JordanAceto/DIY_Synth_Workshop_2020/workshop_docs/pictoral_walkthrough.odp

## Step 1

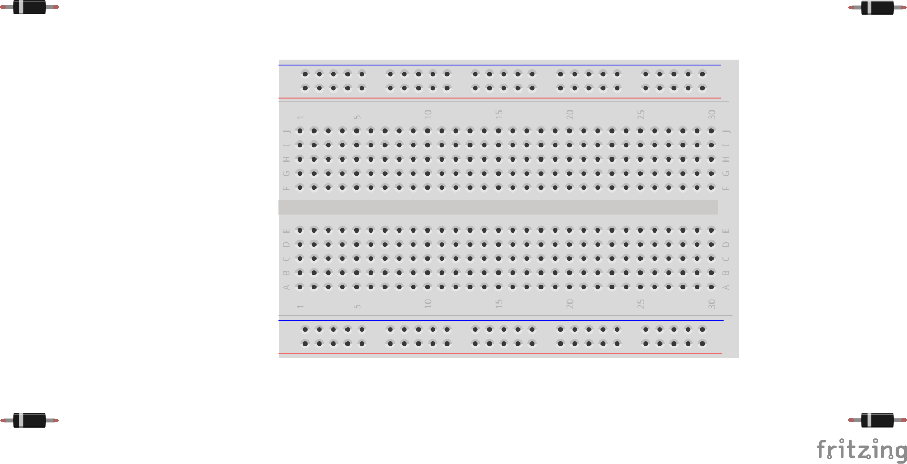
[picture p3: figure]

## Step 2

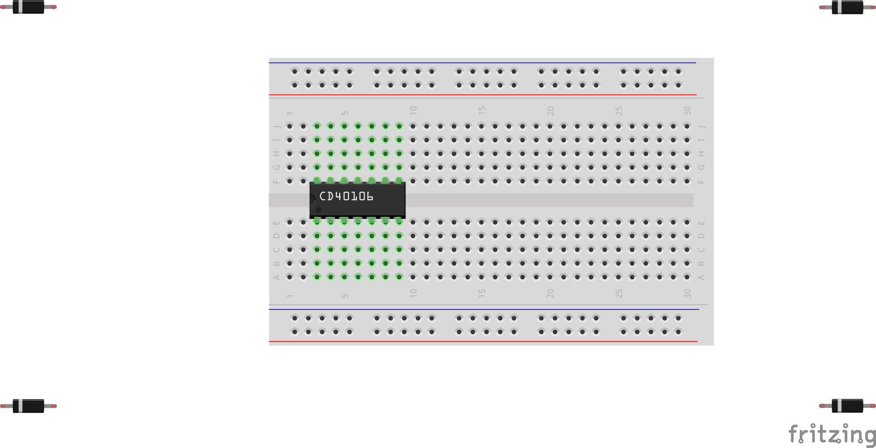
[picture p4: figure]

## Step 3

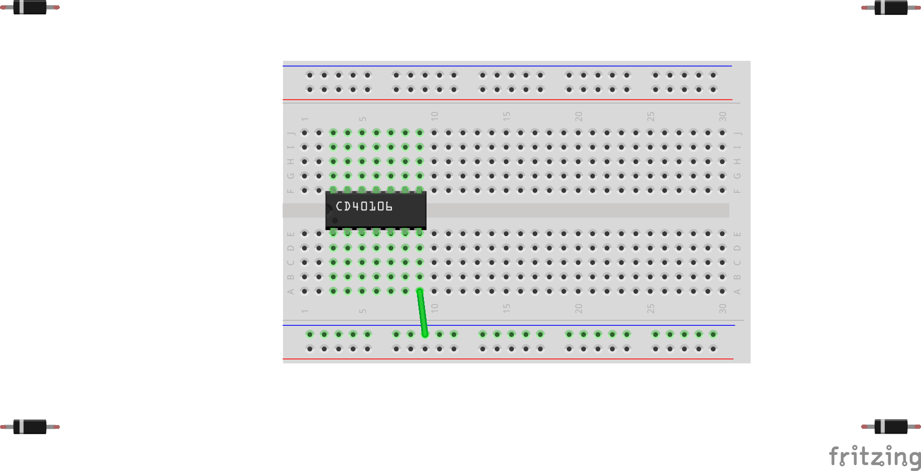
[picture p5: figure]

## Step 4

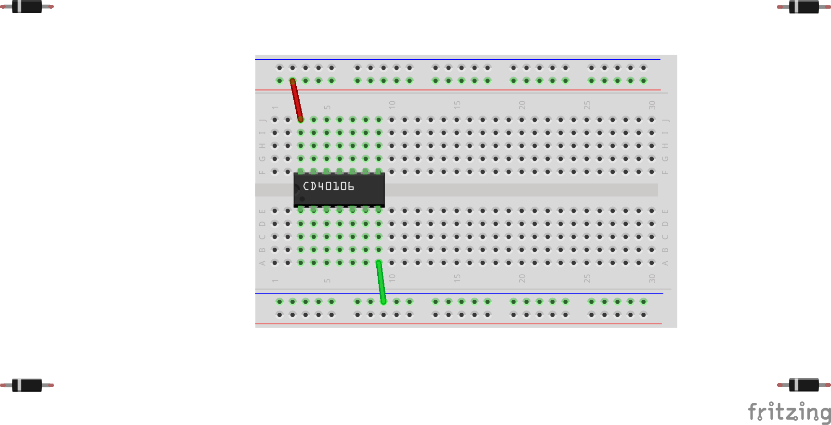
[picture p6: figure]

## Step 5

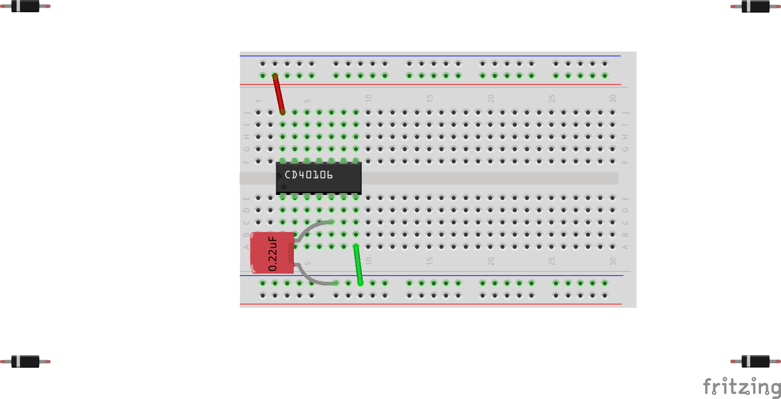
[picture p7: figure]

## Step 6

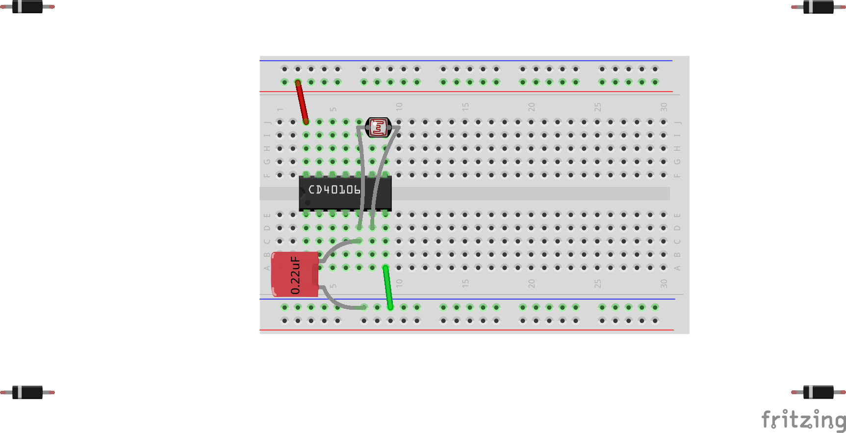
[picture p8: figure]

## Step 7

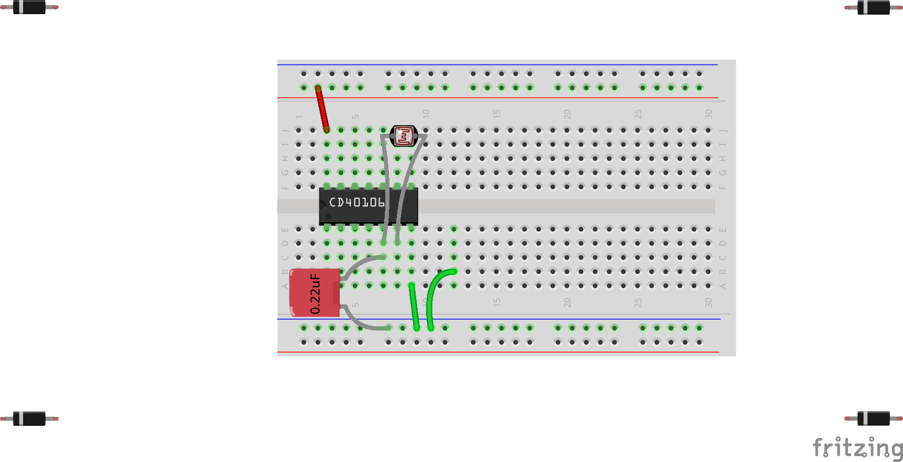
[picture p9: figure]

## Step 8

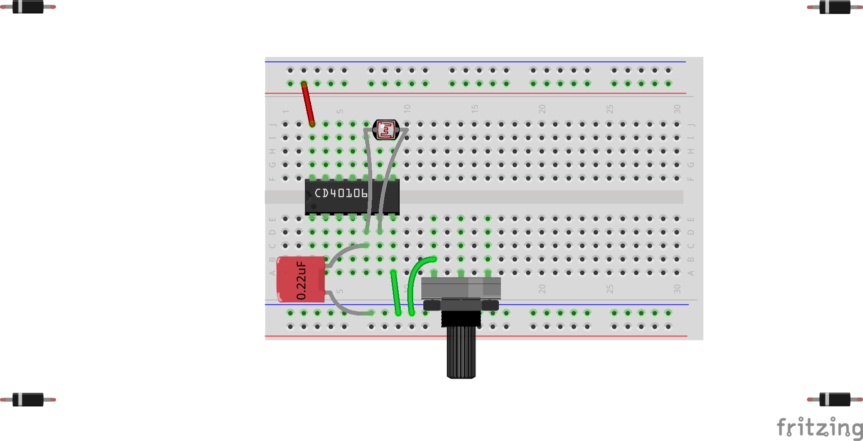
[picture p10: figure]

## Step 9

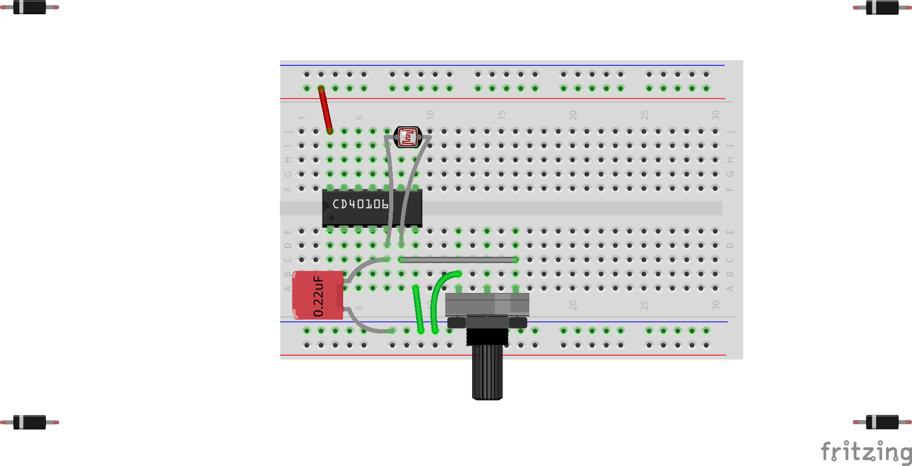
[picture p11: figure]

## Step 10

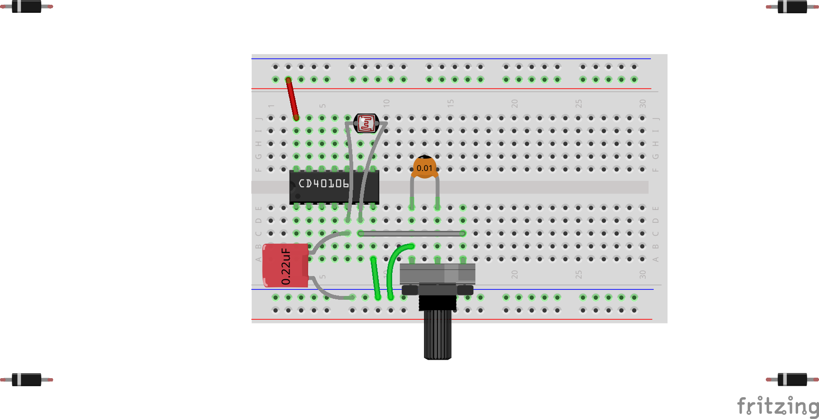
[picture p12: figure]

## Step 11

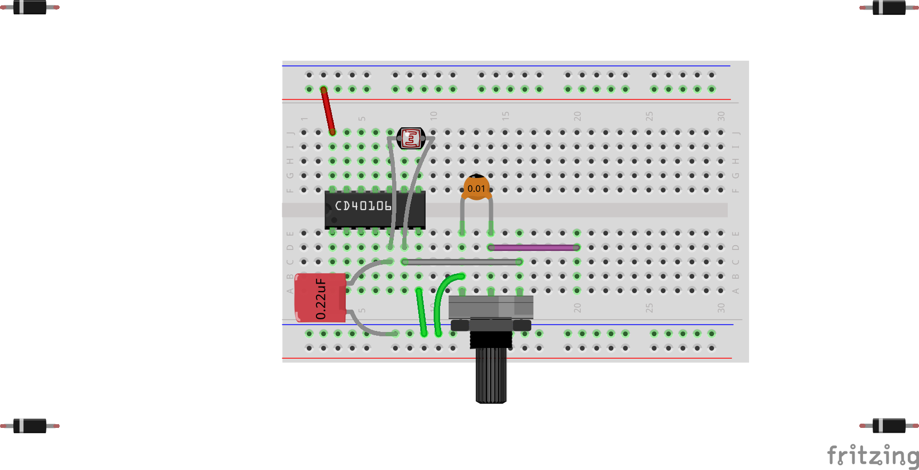
[picture p13: figure]

## Step 12

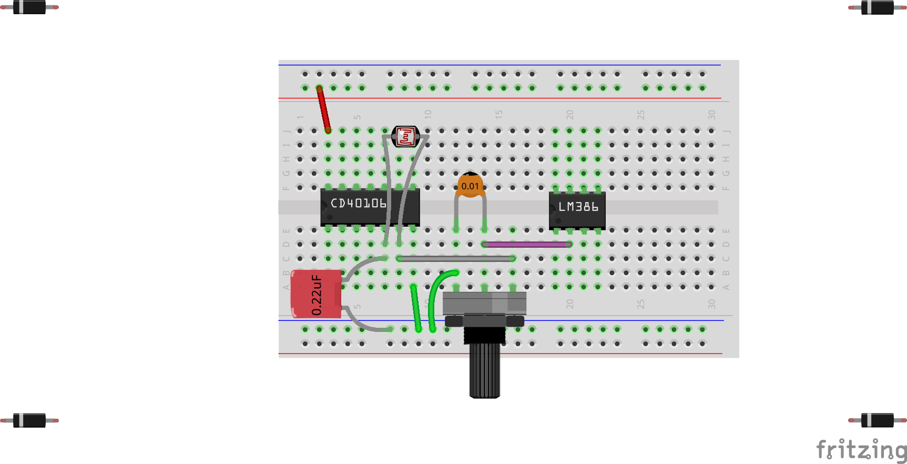
[picture p14: figure]

## Step 13

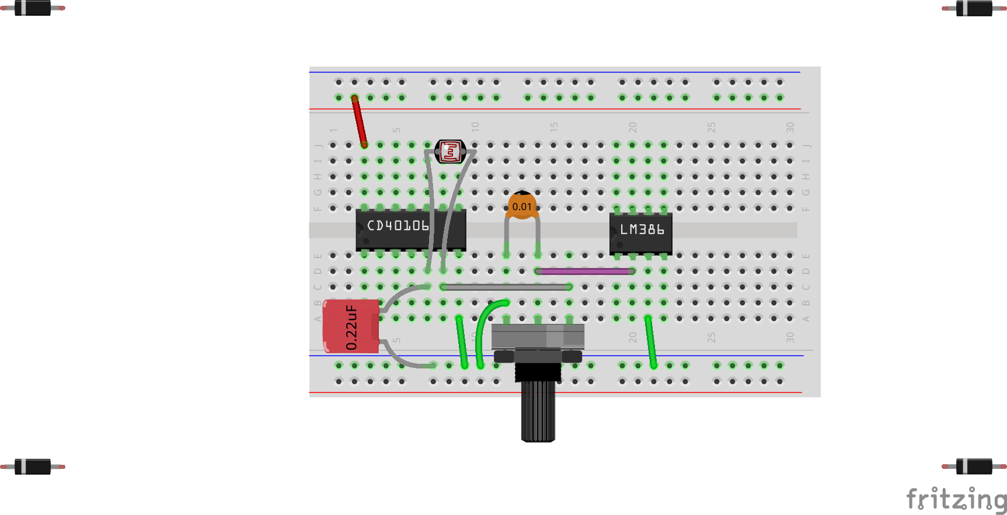
[picture p15: figure]

## Step 14

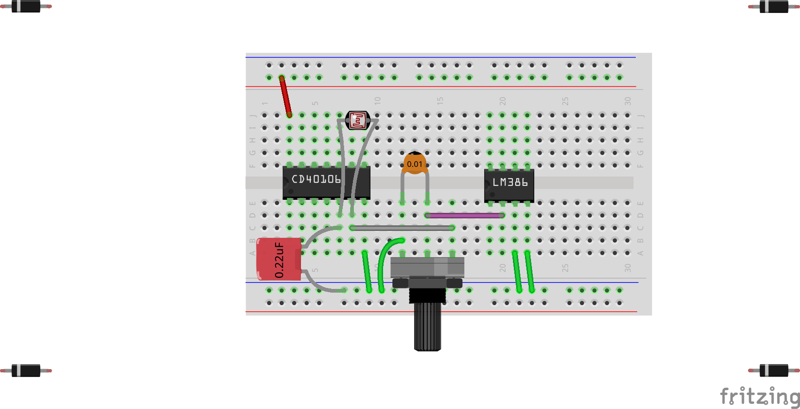
[picture p16: figure]

## Step 15

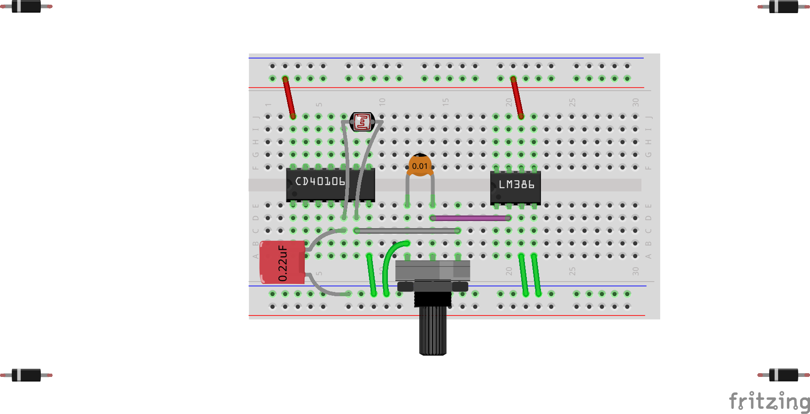
[picture p17: figure]

## Step 16

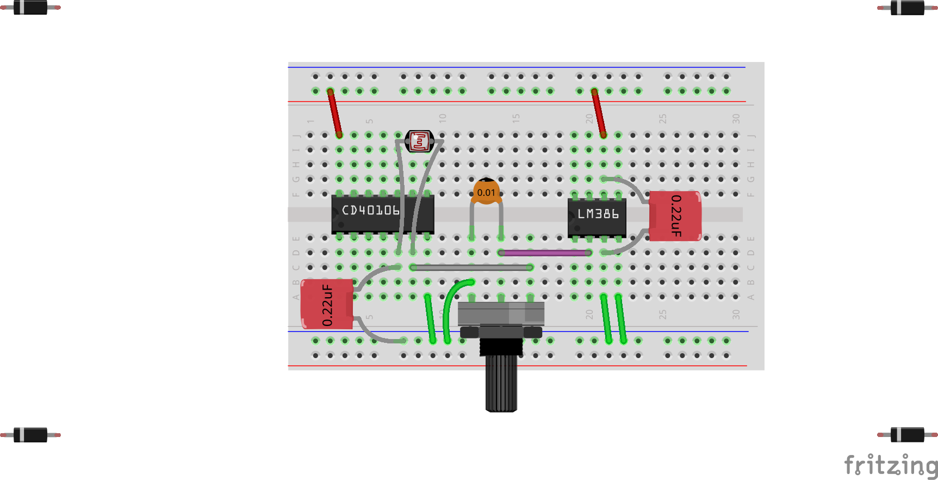
[picture p18: figure]

## Step 17

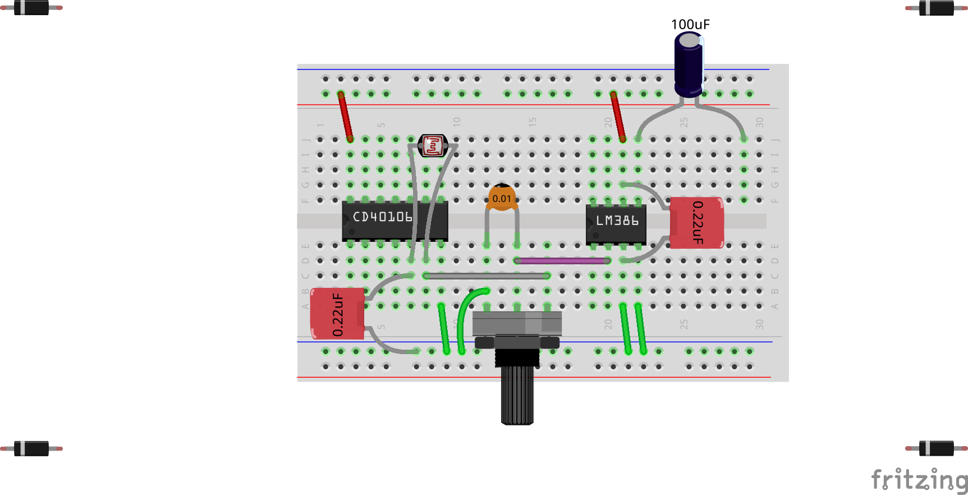
[picture p19: figure]

## Step 18

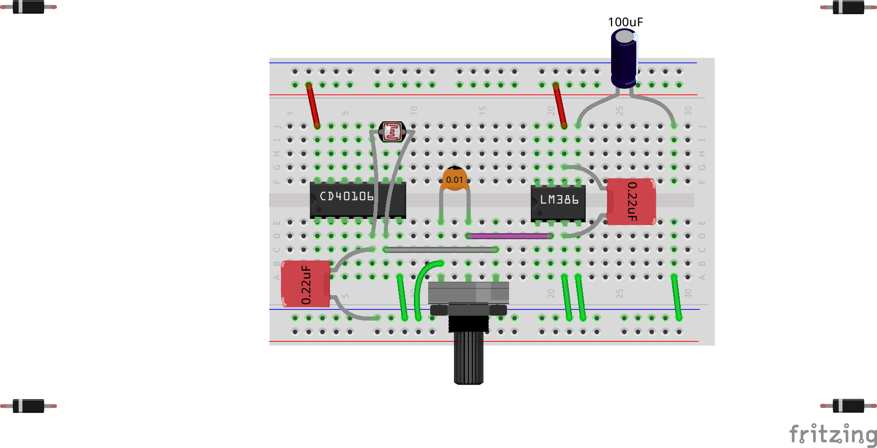
[picture p20: figure]

## Step 19

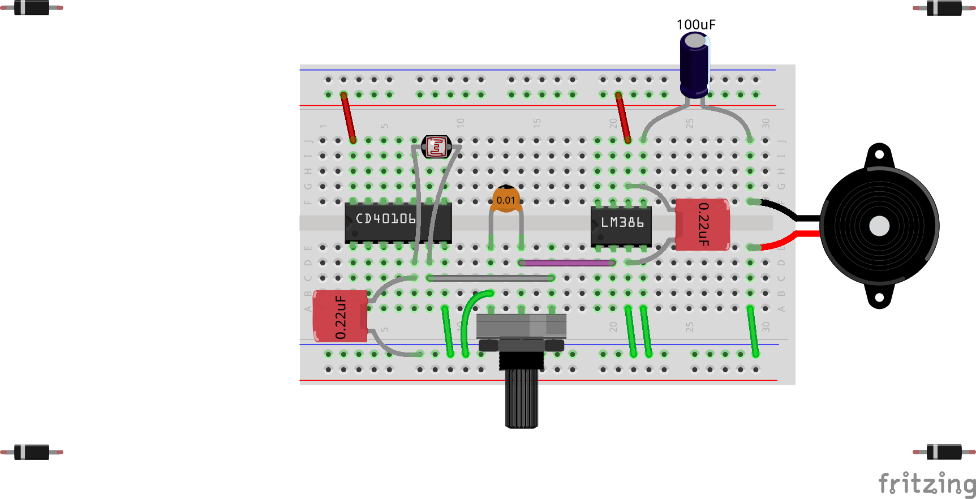
[picture p21: figure]

## Step 20
