JordanAceto/DIY_Synth_Workshop_2020/development_docs/BOM.ods

Description | Mfr # | Distributor # | Quantity | Unit Price | Total Price | Product Page
IC: Low Power Audio Amplifier | LM386n-4/NOPB | 926-LM386N-4/NOPB | 1 | $1.17 | $1.17 | https://www.mouser.com/ProductDetail/926-LM386N-4-NOPB
IC: Hex Schmitt Trigger Inverters | CD40106 | 595-CD40106BE | 1 | $0.52 | $0.52 | https://www.mouser.com/ProductDetail/595-CD40106BE
Breadboard, Clear | PRT-09567 | 474-PRT-09567 | 1 | $4.95 | $4.95 | https://www.mouser.com/ProductDetail/474-PRT-09567
9V Battery Snap | 123-5118-GR | 123-5118-GR | 1 | $0.82 | $0.82 | https://www.mouser.com/ProductDetail/123-5118-GR
16mm Rotary Potentiometer, 100k ohms | 858-P160KN0QC15B100K | 858-P160KN0QC15B100K | 1 | $0.76 | $0.76 | https://www.mouser.com/ProductDetail/858-P160KN0QC15B100K
0.22uF Capacitor | MKS2D032201C00KI00 | 505-MKS2D032201C00KI | 2 | $0.26 | $0.52 | https://www.mouser.com/ProductDetail/WIMA/MKS2D032201C00KI00
0.01uF Capacitor | 1C10Z5U103M050B | 75-1C10Z5U103M050B | 1 | $0.18 | $0.18 | https://www.mouser.com/ProductDetail/Vishay-Sprague/1C10Z5U103M050B
100uF Electrolytic Capacitor | ECA-1EHG101 | 667-ECA-1EHG101 | 1 | $0.30 | $0.30 | https://www.mouser.com/ProductDetail/667-ECA-1EHG101
16 ohm 500 mW Dynamic Speaker | SM3060616-1 | 497-SM3060616-1 | 1 | $2.19 | $2.19 | https://www.mouser.com/ProductDetail/497-SM360616-1
9V Battery | 6LF22XWA/B12 | 658-6LF22XWA/C | 1 | $2.38 | $2.38 | https://www.mouser.com/ProductDetail/658-6LF22XWA-C
All Mouser parts for a single kit: |  |  |  |  | $13.79 | https://www.mouser.com/ProjectManager/ProjectDetail.aspx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
Jumper Wire Kit (enough for ~30 kits) | 923351-I | 517-923351-I | 1 | $52.62 | $52.62 | https://www.mouser.com/ProductDetail/517-923351-I
Light Dependent Resistor (LDR) | 2506A 8005 | 2506A 8005 | 1 | $0.89 | $0.89 | http://smallbear-electronics.mybigcommerce.com/photocells-cds-5mm-diameter/
