JordanAceto/DIY_Synth_Workshop_2020/workshop_docs/schematic.pdf

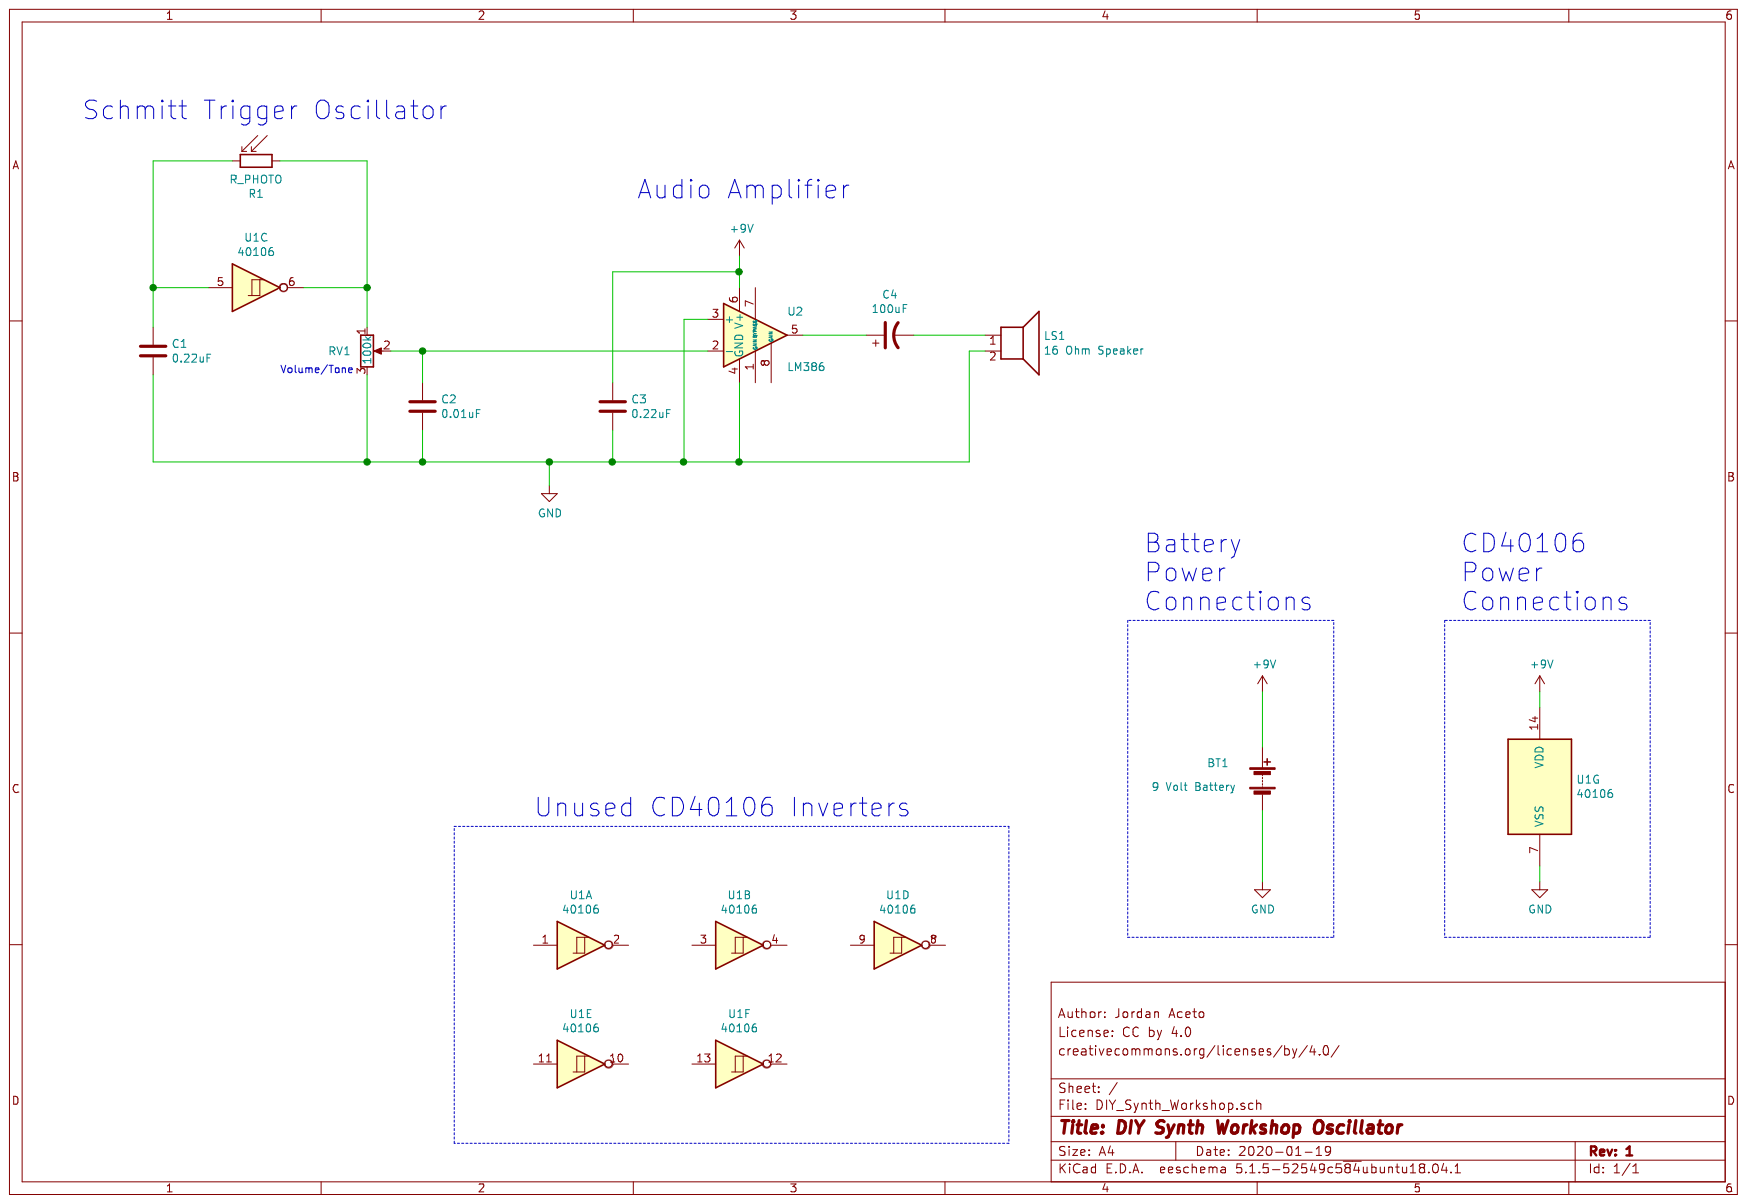
[picture p22: page 1]
