JordanAceto/DIY_Synth_Workshop_2020/(list of files, drawings)

Other design files:
development_docs/fritzing_docs/layout.fzz
