JordanAceto/DIY_Synth_Workshop_2020/(threads)

Thread 1 (2020-02-29):

The jumper wire kit is not ideal

JordanAceto, 2020-02-29:
The chosen jumper wire kit requires a bunch of wire trimming and bending. This gets old pretty fast.

It would be much nicer if the jumper wires were all pre-cut to the correct lengths, and in the correct colors.

To fix this issue, choose a different source for the jumper wires. When a source is chosen update the BOM, mouser card, and README.

Thread 2 (2020-02-29):

The layout is slightly wrong.

JordanAceto, 2020-02-29:
The purple wire going from the wiper of the pot to the LM386 is 7 holes long on the layout. The actual purple wires in the chosen jumper wire kit are 8 holes long.

This is not a huge deal, but it can be confusing for newcomers if the layout does not exactly match reality.

To fix this issue, either change the layout purple wire to blue (the blue wire in the jumper kit is 7 holes long), or move the audio amp circuit one hole to the right and elongate the purple wire.

Note that you'll need to update the layout in several places:
- the picture for the README
- most of the pictures in the powerpoint presentation
- the layout in the handout document
