JordanAceto/DIY_Synth_Workshop_2020/(commit log)

2020-01-19 initial commit, BOM and readme started
    [BOM.ods]
2020-01-19 add schematic
2020-01-19 change cap so color matches fritzing doc
    [BOM.ods]
2020-01-19 move stuff into dev and workshop dirs, add to readme
    [BOM.ods, DIY_Synth_Workshop.sch, layout.fzz]
2020-01-20 change 0.22uF cap type in BOM
    [BOM.ods]
2020-01-20 update layout to reflect new cap type
    [layout.fzz]
2020-01-20 fix BOM fonts, tidy up BOM
    [BOM.ods]
2020-01-20 tidy up fritzing layout
    [layout.fzz]
2020-01-20 make power point of pictoral walkthrough, move pngs into dev docs
2020-01-20 add note about modifying materials to readme
2020-02-05 fix speaker impedance typo in BOM
    [BOM.ods]
2020-02-05 fix speaker impedance typo in schematic
